jpetrocik/ucigate_ram/hardware/Shield.brd

## EAGLE design hardware/Shield.brd (2018-03-16)

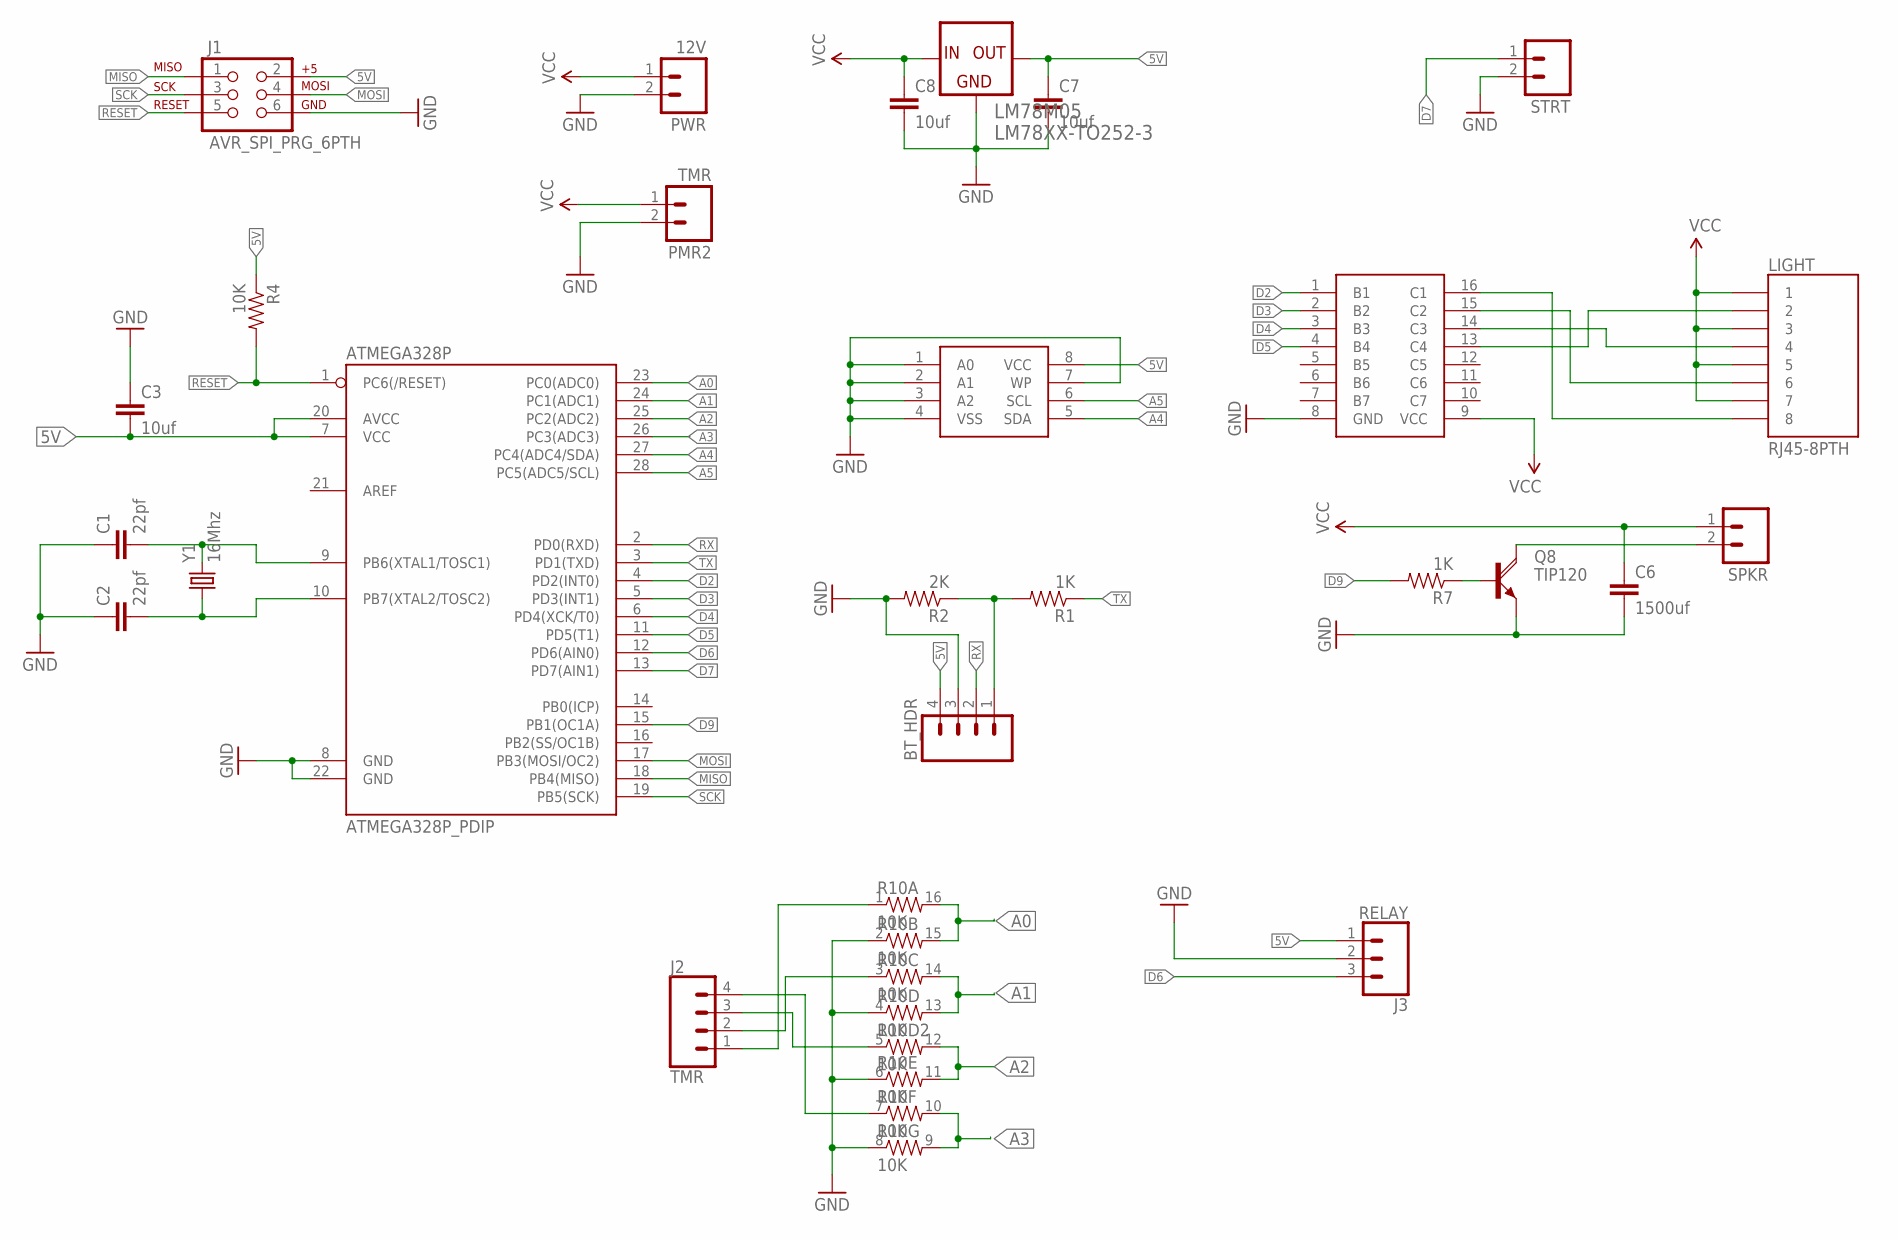
[picture p1: schematic Shield.sch]

Parts:
24AA512: 24AAXXX; SOIC-8-EIAJ
ATMEGA328P: ATMEGA328P_PDIP; DIL28-3
BT_HDR: M04PTH; 1X04@1
C1, C2: 22pf; 1206
C3: 10uf; 1206
C6: 1500uf; CAP-PTH-5MM
C7, C8: 10uf; CAP-PTH-SMALL
J1: AVR_SPI_PRG_6PTH; 2X3
J2: TMR; SCREWTERMINAL-3.5MM-4
J3: RELAY; SCREWTERMINAL-3.5MM-3
LIGHT: RJ45-8PTH; RJ45-8
LM78M05: LM78XX-TO252-3; TO252-3
MC1413D: MC1413D; SO016
PMR2: TMR; SCREWTERMINAL-3.5MM-2
PWR: 12V; SCREWTERMINAL-3.5MM-2
Q8: TIP120; TO220V
R1, R7: 1K; 1206
R2: 2K; 1206
R4: 10K; 1206
R10: 10K; SO016
SPKR: M023.5MM; SCREWTERMINAL-3.5MM-2
STRT: M023.5MM; SCREWTERMINAL-3.5MM-2
Y1: 16Mhz; HC49US

Connections:
5V: 24AA512.8 (VCC), ATMEGA328P.7 (VCC), ATMEGA328P.20 (AVCC), BT_HDR.4, C3.2, C7.1, J1.2, J3.1, LM78M05.3 (OUT), R4.1
A0: ATMEGA328P.23 (PC0(ADC0)), R10.15 (2), R10.16 (2)
A1: ATMEGA328P.24 (PC1(ADC1)), R10.13 (2), R10.14 (2)
A2: ATMEGA328P.25 (PC2(ADC2)), R10.11 (2), R10.12 (2)
A3: ATMEGA328P.26 (PC3(ADC3)), R10.9 (2), R10.10 (2)
A4: 24AA512.5 (SDA), ATMEGA328P.27 (PC4(ADC4/SDA))
A5: 24AA512.6 (SCL), ATMEGA328P.28 (PC5(ADC5/SCL))
D2: ATMEGA328P.4 (PD2(INT0)), MC1413D.1 (B1)
D3: ATMEGA328P.5 (PD3(INT1)), MC1413D.2 (B2)
D4: ATMEGA328P.6 (PD4(XCK/T0)), MC1413D.3 (B3)
D5: ATMEGA328P.11 (PD5(T1)), MC1413D.4 (B4)
D6: ATMEGA328P.12 (PD6(AIN0)), J3.3
D7: ATMEGA328P.13 (PD7(AIN1)), STRT.1
D9: ATMEGA328P.15 (PB1(OC1A)), R7.2
GND: 24AA512.1 (A0), 24AA512.2 (A1), 24AA512.3 (A2), 24AA512.4 (VSS), 24AA512.7 (WP), ATMEGA328P.8 (GND), ATMEGA328P.22 (GND), BT_HDR.3, C1.1, C2.1, C3.1, C6.2, C7.2, C8.2, J1.6, J3.2, LM78M05.2 (COM), MC1413D.8 (GND), PMR2.2, PWR.2, Q8.3 (E), R2.2, R10.2 (1), R10.4 (1), R10.6 (1), R10.8 (1), STRT.2
MISO: ATMEGA328P.18 (PB4(MISO)), J1.1
MOSI: ATMEGA328P.17 (PB3(MOSI/OC2)), J1.4
unnamed: BT_HDR.1, R1.2, R2.1
unnamed: LIGHT.8, MC1413D.16 (C1)
unnamed: LIGHT.4, MC1413D.14 (C3)
unnamed: LIGHT.2, MC1413D.13 (C4)
unnamed: LIGHT.6, MC1413D.15 (C2)
unnamed: J2.1, R10.1
unnamed: J2.4, R10.7 (1)
unnamed: Q8.2 (C), SPKR.2
unnamed: ATMEGA328P.9 (PB6(XTAL1/TOSC1)), C1.2, Y1.2
unnamed: J2.2, R10.3 (1)
unnamed: Q8.1 (B), R7.1
unnamed: J2.3, R10.5 (1)
unnamed: ATMEGA328P.10 (PB7(XTAL2/TOSC2)), C2.2, Y1.1
RESET: ATMEGA328P.1 (PC6(/RESET)), J1.5, R4.2
RX: ATMEGA328P.2 (PD0(RXD)), BT_HDR.2
SCK: ATMEGA328P.19 (PB5(SCK)), J1.3
TX: ATMEGA328P.3 (PD1(TXD)), R1.1
VCC: C6.1, C8.1, LIGHT.1, LIGHT.3, LIGHT.5, LIGHT.7, LM78M05.1 (IN), MC1413D.9 (VCC), PMR2.1, PWR.1, SPKR.1

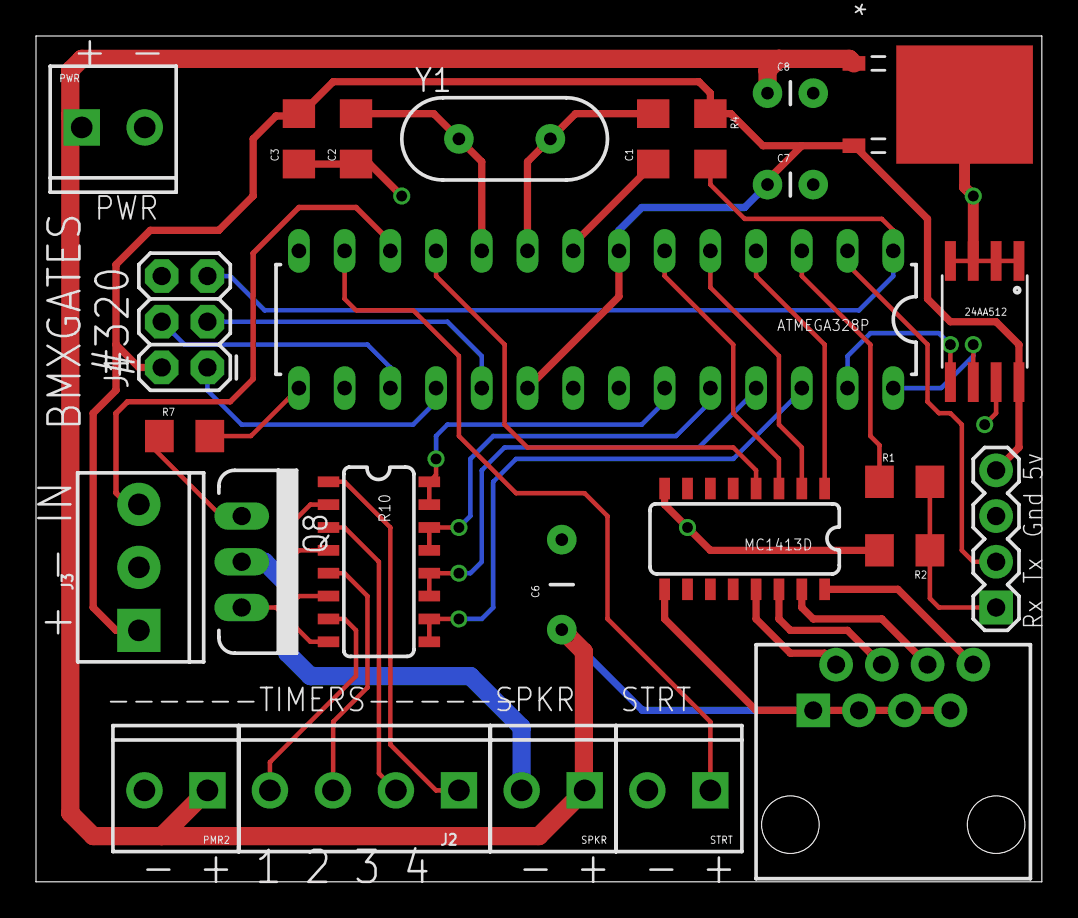
[picture p2: board Shield.brd from above]

Board: 2 copper layers, 55.9 x 47.0 mm, 26 parts (0 on the bottom side), 35 nets.
