jpetrocik/ucigate_ram/firmware/configuration.h

#define BOARD_V4_3

/**
 * A very long debounce delay, so if the user accidentally
 * presses the button multiple time, it's not interrupted 
 * as multiple presses
 */
#define DEBOUNCE_DELAY 1000

/**
 * Firmware Version number
 */
#define FIRMWARE_VERSION "1.2.0-RAM"

/**
 * The time in millis before green 0-120 are valid
 */
#define GATE_RELEASE_ADJUSTMENT 70

#if defined (BOARD_V4_1)  || defined (BOARD_V4_2) || defined (BOARD_V4_3) 
  #define GATE 6
  #define LIGHT_RED 3
  #define LIGHT_YELLOW_1 4
  #define LIGHT_YELLOW_2 5
  #define LIGHT_GREEN 2
  #define SPEAKER 9
  #define START 7
  #define TIMER_1 17
  #define TIMER_2 16
  #define TIMER_3 15
  #define TIMER_4 14
#endif


/**
 * Changable for boards where UART is a SerialX
 */
#define SerialPort Serial
