jpetrocik/ucigate_ram/(commit log)

2014-10-30 3.X r56
    [Shield.brd, Shield.sch]
2014-11-07 Converted to single board
    [Shield.brd, Shield.sch]
2014-11-09 Final 3.0
    [Shield.brd]
2014-12-05 Improvement component placement
    [Shield.brd, Shield.sch]
2014-12-05 Added missing trace
    [Shield.brd]
2014-12-05 Update revision number
    [Shield.brd]
2017-11-13 Fixed 12v relay voltage
    [Shield.brd, Shield.sch]
2017-11-13 Moved to hardware
    [Shield.brd, Shield.sch]
2017-11-13 Merged firmware into hardwre project to keep them together
    [configuration.h]
2017-11-13 Restored lost RAM board design during migration from svn
    [DigiKey.csv, Shield.brd, Shield.sch]
2017-11-13 Removed MAG_GATE
    [configuration.h]
2017-11-13 Change BOARD DEFINE version to all 3.x boards
    [configuration.h]
2017-11-13 Fixed rogue wires
    [Shield.brd]
2017-11-24 Untested timer logic
    [configuration.h]
2018-02-22 Starting 4.3 board developement
    [Shield.brd, Shield.sch, configuration.h]
2018-02-22 Fix nextSplitTimer assignment
    [configuration.h]
2018-02-22 Fixed reversed pos/neg labels for power
    [Shield.brd]
2018-03-11 Moved main cap
    [Shield.brd]
2018-03-11 Removed outdate board pin configuration
    [configuration.h]
2018-03-16 Changed light pin configuration
    [configuration.h]
2018-03-16 Fixed positive and negative labels
    [Shield.brd, Shield.sch]
2018-03-16 Fixed gnd plan shape
    [Shield.brd]
